asifahamed-ece/UsbAudioDac/USB_Audio_DAC_1.0/Core/Src/main.c

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
/* Includes ------------------------------------------------------------------*/
#include "main.h"
#include "usb_device.h"

/* USER CODE BEGIN Includes */
#include "audio_i2s.h"
#include "audio_fft.h"
#include "visualizer.h"
/* USER CODE END Includes */

I2S_HandleTypeDef hi2s2;
DMA_HandleTypeDef hdma_spi2_tx;

/* USER CODE BEGIN PV */
/* The 1 kHz sine test buffer (AUDIO_BUFFER[882]) and the
 * Phase 2 sine-generation code are removed. The DMA now runs
 * on audio_i2s_buffer (in audio_i2s.c), which the I2S callbacks
 * refill from the USB ring buffer. */

/* Independent watchdog (~1 s window, refreshed every main-loop pass).
 * File-scope (not static) so the CubeMX-generated handle stays visible to
 * the IWDG HAL; instance is the shared IWDG peripheral. */
IWDG_HandleTypeDef hiwdg;
/* USER CODE END PV */

void SystemClock_Config(void);
static void MX_GPIO_Init(void);
static void MX_DMA_Init(void);
static void MX_I2S2_Init(void);
/**
  * @brief  The application entry point.
  * @retval int
  */
int main(void)
{

  /* MCU Configuration--------------------------------------------------------*/

  /* Reset of all peripherals, Initializes the Flash interface and the Systick. */
  HAL_Init();

  /* Configure the system clock */
  SystemClock_Config();

  /* USER CODE BEGIN SysInit */
  /* Spectrum visualizer: arm the FFT double-buffer BEFORE
   * AudioI2S_Init() starts circular DMA — otherwise the refill ISR
   * (DMA1_Stream4, priority 0) could call AudioFFT_PutSamples()
   * while Init clears flags / memset(tap_buf) / builds the Hann
   * window. AudioFFT_Init has no I2S/USB dependency (RFFT table,
   * window, flags only). */
  AudioFFT_Init();
  /* USER CODE END SysInit */

  /* Initialize all configured peripherals */
  MX_GPIO_Init();
  MX_DMA_Init();
  MX_I2S2_Init();

  /* Start the I2S consumer BEFORE USB enumeration so the
   * peripheral is already clocking out silence from a zeroed
   * buffer. When the USB host opens its audio pipe and the
   * ring starts filling, the I2S callbacks (in stm32f4xx_it.c)
   * will start pulling samples from the ring into the buffer.
   *
   * Order matters: if USB started first, the ring would fill
   * but nothing would drain it — by the time I2S started, the
   * ring could be overflowing on a bursty source. */
  AudioI2S_Init();

  MX_USB_DEVICE_Init();
  /* USER CODE BEGIN 2 */
  /* (Phase 2 1 kHz sine generation removed; the I2S DMA now
   * streams from audio_i2s_buffer, which is refilled from the
   * USB ring buffer.) */

  /* TFT visualizer: ST7735 SPI bring-up + splash. Must run BEFORE
   * the IWDG starts — the splash blocks in HAL_Delay for ~3.5 s,
   * which would trip a ~1 s watchdog mid-animation and reset the MCU. */
  Visualizer_Init();

  /* Start the independent watchdog: LSI (~32 kHz) / 64 = 500 Hz,
   * reload 500  ->  ~1.0 s timeout. Refresh happens in the main
   * loop; a hang ends in an IWDG reset instead of a dead device.
   *
   * NOTE: IWDG keeps counting while the CPU is halted, so with the
   * watchdog enabled a debugger cannot halt the core (it resets
   * ~1 s later). Build with -DDEBUG_NO_WATCHDOG to disable it for
   * SWD debugging. */
#if !defined(DEBUG_NO_WATCHDOG)
  hiwdg.Instance = IWDG;
  hiwdg.Init.Prescaler = IWDG_PRESCALER_64;
  hiwdg.Init.Reload = 500;
  if (HAL_IWDG_Init(&hiwdg) != HAL_OK)
  {
    Error_Handler();
  }
#endif
  /* USER CODE END 2 */

  /* Infinite loop */
  /* USER CODE BEGIN WHILE */
  while (1)
  {
#if !defined(DEBUG_NO_WATCHDOG)
    HAL_IWDG_Refresh(&hiwdg);
#endif
    /* USER CODE END WHILE */

    /* USER CODE BEGIN 3 */
    Visualizer_Update();
  }
  /* USER CODE END 3 */
}

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
/* USER CODE BEGIN 4 */

/* HAL I2S callbacks (HAL_I2S_TxHalfCpltCallback / HAL_I2S_TxCpltCallback)
 * are implemented in stm32f4xx_it.c — they route to AudioI2S_RefillHalfA/B
 * which pull samples from the ring buffer. See stm32f4xx_it.c. */

/* USER CODE END 4 */
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
