asifahamed-ece/UsbAudioDac/USB_Audio_DAC_1.0/USB_Audio_DAC_1.0.ioc

Mcu.UserName=STM32F411CEUx
PA11.Signal=USB_OTG_FS_DM
PA12.Signal=USB_OTG_FS_DP
PA9.Signal=USB_OTG_FS_VBUS
PB10.Signal=I2S2_CK
PB12.Signal=I2S2_WS
PB15.Signal=I2S2_SD
