asifahamed-ece/UsbAudioDac/(commit log)

2026-09-04 Add BOM
2026-09-04 Update : Sine wave Intro and Bug fixes
    [main.c]
2026-09-05 Config I2S Clock Bus fixed
    [USB_Audio_DAC_1.0.ioc]
2026-09-05 Update Fixed the 1 KHz Sine Generation
    [main.c]
2026-09-05 Add ST USB Device Library (Audio + Core)
    Vendor library from STMicroelectronics, unmodified. Provides the
    USB Audio Class 1.0 class driver (usbd_audio.c) and the OTG FS
    core (usbd_core.c, usbd_ctlreq.c, usbd_ioreq.c). Application
    side is wired up in USB_DEVICE/App/ in a follow-up commit.
2026-09-05 Wire up USB Audio device on Black Pill
    - USB_DEVICE/App/usbd_audio_if.c: bridges the class driver to
    our ring buffer; AUDIO_CMD_PLAY calls RingBuffer_Write with the
    host's isochronous OUT packet. HalfTransfer_CallBack_FS and
    TransferComplete_CallBack_FS are the user-side hooks that the
    I2S HAL callbacks must invoke (the ST library never calls them
    itself - this is the root cause of the silent-enumeration bug).
    - USB_DEVICE/App/usbd_desc.c: device descriptor + configuration
    descriptor; one mono streaming endpoint, bNrChannels=1.
    - USB_DEVICE/Target/usbd_conf.c: HAL_PCD_MspInit, vbus_sensing
    DISABLE (F411 PA9 isn't routed to VBUS on the WeAct Black Pill,
    so B-session detection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
2026-09-05 Add ring buffer, I2S consumer, and USB Sync wiring
    - ring_buffer.c: SPSC ring (1024 int16, power of 2) shared
    between the USB producer (in usbd_audio_if.c) and the I2S
    consumer. head==tail is empty; one slot is sacrificed to
    disambiguate full. No locks - safe because USB writes from a
    single ISR and I2S reads from a single ISR.
    - audio_i2s.c: pulls mono int16 from the ring and lays them
    into the I2S DMA buffer as L=R (stereo). Underrun policy is
    silence (memset zero), so a brief stall doesn't pop.
    - stm32f4xx_it.c: HAL_I2S_TxHalfCplt/TxCplt callbacks now call
    HalfTransfer_CallBack_FS/TransferComplete_CallBack_FS FIRST
    (which routes to USBD_AUDIO_Sync -> AUDIO_CMD_PLAY ->
    Ri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
    [audio_i2s.c, audio_i2s.h, main.c, ring_buffer.c, ring_buffer.h]
2026-09-05 Update Makefile and CubeMX project for USB + I2S
    - Makefile: add C sources for new ring_buffer, audio_i2s, and
    USB device app/conf files; include paths for the ST USB
    Middleware and USB_DEVICE directories.
    - .ioc: enable USB OTG FS Device_Only, add DMA1 Stream4
    request for I2S2_TX, set USBD_AUDIO_FREQ=44100, add I2S2
    master-receive configuration. Generated by CubeMX; do not
    hand-edit between regenerations.
2026-09-05 Sync PROGRESS and PLAN with the working Phase 3 state
    Three categories of correction:
    - Clock config: both docs described a 60 MHz SYSCLK design that
    was never actually put in the .ioc. The board runs 48 MHz
    (PLLM=25, PLLN=384, PLLP=DIV8). Updated Phase 1 config,
    clock-tree math, and the H2 heading.
    - Phase 3 marked complete. Final config is 44.1 kHz / 16-bit /
    mono, 88-byte packets every 1 ms, ring buffer 1024 int16
    (~23 ms). Replaced the 48 kHz / 480-sample planning numbers
    with the actual numbers from the .ioc and usbd_conf.h.
    - Three-bug story added to PROGRESS.md: VBUS sensing blocking
    D+ pull-up (Bug 1, usbd_conf.c:342), hardcoded
    USBD_AUDIO_FREQ=48000U in usbd_conf.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
2026-09-10 docs: add README.md with project overview, build instructions, and wiring diagrams
2026-09-10 docs: fix CLAUDE.md — correct PLLI2SR=2, I2S=96MHz, source structure, pins
2026-09-10 docs: fix CLAUDE.md — correct sample rate to 44.1kHz, I2S pins PB10, status to Phase 3
2026-09-10 docs: fix PROGRESS.md — correct PLLI2SR=2, I2S=96MHz, PLLI2S config location
2026-09-10 docs: fix IMPLEMENTATION_PLAN.md — correct PLLI2SR=2, I2S=96MHz, SPI1/ST7735S, bmAttributes=0x00
2026-09-17 ld: add CCMRAM region/section, bump stack to 0x1000
    Resolve two deferred items: expose the 64K CCMRAM at 0x10000000 via a
    .ccmram section (NOLOAD, CPU-only - DMA buffers must stay in RAM), and
    raise _Min_Stack_Size to 0x1000 to make room for printf/FreeRTOS later.
2026-09-17 tests: add host unit tests for SPSC ring buffer
    Host-simulated suite for the USB->I2S lock-free ring: empty/full
    invariants, power-of-2 wraparound, partial ops, reset, 5000-iteration
    producer/consumer churn, and a global-stream integrity check across
    many wraps. ring_buffer.c compiles unmodified with host gcc (no HAL).
    Run with: make -C tests run. Clean under ASan/UBSan; 5227 checks pass.
2026-09-17 wdog: supervise main loop with independent watchdog (~1s)
    Enable HAL_IWDG_MODULE_ENABLED, link the IWDG driver, and start the
    windowless watchdog in main() USER CODE 2 (LSI/64 = 500 Hz, reload 500
    -> ~1.0 s). Refreshed each main-loop pass in USER CODE 3. A stuck main
    loop or hard fault now ends in a clean reset instead of a dead device.
    All IWDG wiring stays inside USER CODE blocks so CubeMX regeneration
    won't clobber it.
    [main.c]
2026-09-17 build: add flash/test/size convenience targets
    make flash - st-flash write the built .bin at 0x08000000
    make test - run host-simulated ring-buffer unit tests
    make size - print per-section memory usage of the .elf
    flash and size depend on the built artifacts; test needs no ARM toolchain.
2026-09-19 Rm BOM
2026-09-19 Added Wiring Pin Config
2026-09-19 Updated : Added Wiring Configs
2026-09-19 Updated MAX Wiring
2026-09-20 Update Fix Samples Overflow
    [main.c]
2026-09-20 Fix USBD_AUDIO_Sync stale data: compute available bytes and pass rd_ptr offset
    AudioCmd typedef now accepts a uint32_t offset parameter so the
    callback knows where in the circular buffer fresh data starts.
    USBD_AUDIO_Sync previously always copied AUDIO_TOTAL_BUF_SIZE/2
    (3520 bytes) from buffer[0] regardless of how much new USB data had
    arrived. Only ~440 bytes were fresh; the rest were stale zeros,
    filling the ring buffer with silence interspersed with real audio.
    Now computes actual available bytes (forward distance from rd_ptr to
    wr_ptr), clamps to half-buffer max, saves old_rd_ptr before advance,
    and passes it as the offset to AudioCmd. The ±4 byte proportional
    adjustment (insufficient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
2026-09-20 Adapt AudioCmd callback to use circular buffer offset
    AUDIO_AudioCmd_FS now receives the byte offset into the USB
    intermediate buffer where fresh data starts (old_rd_ptr from
    USBD_AUDIO_Sync). Reads from (pbuf + offset) instead of pbuf,
    ensuring the ring buffer receives actual audio samples instead of
    stale zeros from the start of the circular buffer.
    Template file updated to match the new AudioCmd signature.
2026-09-20 Fix circular buffer wrap-around in USBD_AUDIO_Sync
    When old_rd_ptr + BufferSize crosses the end of haudio->buffer[],
    the contiguous read from buffer[old_rd_ptr] would read past the
    array boundary into the struct's offset/rd_ptr/wr_ptr fields.
    Those stale struct values were interpreted as audio samples,
    causing the harmonic echo artifacts and clicks.
    Split the AudioCmd transfer into two calls when wrapping:
    1. first_chunk: from old_rd_ptr to end of buffer
    2. second_chunk: from start of buffer for the remainder
    Each chunk is independently capped by the ring buffer's own
    overflow protection in RingBuffer_Write.
2026-09-21 audio_i2s.c: add consumer-boundary diagnostics for ~100 Hz artifact
    Non-behavioral counters at the I2S half refill (5 ms cadence) to localize
    the 100 Hz gap seen on a steady 1 kHz tone:
    dbg_refill_calls - total HalfA+HalfB refills (events/sec = count/seconds)
    dbg_partial_count - refills that got < 220 mono (consumer starvation)
    dbg_partial_short - total missing mono samples
    dbg_late_gap - refill gaps > 6 ms (missed half window / latency)
    dbg_max_gap_ms - largest inter-refill gap
    dbg_min_read - smallest mono read this run
    Read via SWD/GDB while the tone chatters. Non-zero partial_count at
    ~200/s => starvation; non-zero late_gap => callback latency. Bui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
    [audio_i2s.c]
2026-09-21 usbd_audio: make USB->I2S bridge lossless (ring backpressure + sizing)
    The producer (USBD_AUDIO_Sync -> AUDIO_CMD_PLAY) could push up to
    AUDIO_TOTAL_BUF_SIZE/2 = 1760 mono samples per sync, but the consumer
    ring only held 1023 and AUDIO_AudioCmd_FS silently dropped overflow
    while Sync advanced rd_ptr past the unwritten bytes. That silent loss
    produced cadence glitches (the ~100 Hz / multi-frequency buzz on a
    steady 1 kHz tone).
    Fix (two parts, kept consistent):
    - RING_BUFFER_SIZE 1024 -> 2048 (>= worst-case single sync push)
    - USBD_AUDIO_Sync caps its per-sync copy to the ring's free space, so
    rd_ptr never advances past data the PLAY callback cannot store:
    lossless backpressure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
    [ring_buffer.h]
2026-09-21 audio_i2s: fix I2S buffer size 882->880 for stereo frame alignment
    The DMA half of an 882-halfword buffer is 441 words = an ODD count, so
    the 5 ms half-boundary split a stereo frame (L/R in different halves),
    leaving a stale word at every boundary. This injected a ~200 Hz / 100 Hz
    amplitude-phase glitch confirmed by recording analysis (200.01 Hz envelope
    peak, 100.2 Hz autocorr) and by the frequency meter oscillating to 100 Hz.
    880 -> half = 440 words = 220 whole stereo frames, exactly matching the
    220-mono refill (440 words). RefillHalfA writes 0..439, RefillHalfB
    440..879; fully aligned, no stale word.
    Also: silence -Wmemset-elt-size (byte count == element count now) and
    update stale 8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
    [audio_i2s.c, audio_i2s.h]
2026-09-21 usbd_audio: accept the 90-byte USB long frame (was dropping 1 sample/10 ms)
    For mono 44.1 kHz the host sends 9 packets of 88 bytes + 1 packet of 90
    bytes every 10 ms (44.1 samples/ms). The EP was opened and every
    PrepareReceive sized to AUDIO_OUT_PACKET=88 while the descriptor
    advertised 176 (the stereo macro). The 90-byte long frame was clipped,
    silently dropping 1 mono sample every 10 ms -> the exact 100 Hz glitch
    seen as a 1 kHz<->100 Hz meter hop on a steady tone.
    Fixes (AUDIO_FIX_PLAN Bug 2):
    - header: add AUDIO_OUT_PACKET_MAX 90U (buffer size stays 88*80=7040)
    - descriptor wMaxPacketSize -> LOBYTE/HIBYTE(AUDIO_OUT_PACKET_MAX)=90
    - OpenEP + all three PrepareReceive -> AUDIO_OUT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
2026-09-21 audio_i2s: acoustic-isolation diagnostic - generated 1 kHz (bypass USB)
    Temporary diagnostic to bisect the remaining 200/300 Hz buzz between the
    USB/ring data path and the amplifier/power/speaker.
    When dbg_bypass_usb (default 1) the I2S DMA buffer is filled with a
    phase-continuous generated 1 kHz sine, bypassing USB+ring entirely, while
    leaving DMA1_Stream4 -> I2S2 -> MAX98357A -> speaker unchanged.
    - clean tone => USB/ring path is the culprit (fix feedback / margin)
    - still buzzy => amp/power/speaker is the culprit (hardware)
    Set dbg_bypass_usb=0 over SWD/GDB to restore normal USB playback without
    reflashing. REMOVE after the test.
    [audio_i2s.c]
2026-09-21 usbd_conf: enable SOF interrupt for async feedback endpoint
    FATAL bug fix (AUDIO_FIX_PLAN Bug 1): Sof_enable was DISABLE, which
    masks GINTMSK_SOFM in the USB OTG peripheral (stm32f4xx_ll_usb.c:452).
    Without SOF interrupts USBD_AUDIO_SOF never fires, so the feedback
    endpoint never transmits rate correction to the host.
    Result: host sends at nominal 44100 Hz while I2S consumes at 44117.6 Hz
    (PLLI2S real rate) -> 17.6 samples/s drain -> ring empties in ~113s.
    Fix: Sof_enable = ENABLE. This is the standard ST CubeMX trap for anyone
    adding async feedback to USB Audio Class 1.0 — the .ioc generator defaults
    to DISABLE and never warns you.
2026-09-21 Fix interrupt priority inversion: DMA I2S now preempts USB
    CRITICAL: The 400Hz/300Hz modulation artifacts in recordings 2&3 were
    caused by USB (priority 0) preempting audio DMA callbacks (priority 5).
    SOF interrupts fire at 1000 Hz. When a DMA half-complete ISR starts
    executing RefillHalfA/B at t=5ms, USB can preempt it mid-operation. By
    the time control returns to the DMA ISR, the DMA has already started
    reading the not-yet-refilled buffer -> plays stale/zero data -> 200Hz
    gap pattern -> 400Hz second harmonic.
    New priorities:
    DMA1_Stream4_IRQn = (0, 0) <- HIGHEST (was 5)
    OTG_FS_IRQn = (3, 0) <- LOWER (was 0)
    Audio DMA callbacks are time-critical (must complete within ~5ms)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
    [main.c]
2026-09-23 feat(display): add ST7735S SPI1 driver with 6x8 font and rect primitives
2026-09-23 fix(display): correct RGB565 wire byte order; add display settle delays; stream text per-char window
    [st7735.c]
2026-09-23 feat(ui): wire Visualizer_Init/Update into main loop
2026-09-23 fix(dsp): calibrate dB mapping for full-scale input; drop dead FS macro
    [audio_fft.c, audio_fft.h]
2026-09-23 fix: arm AudioFFT before live I2S ISR; correct spec band index; render clamp
    [audio_fft.c, main.c, visualizer.c]
2026-09-23 fix: move Visualizer_Init after USB enumeration to avoid host timeout
    USB hosts expect enumeration within ~100ms. The previous order had
    AudioFFT_Init + Visualizer_Init (~1.5s of delays: 450ms ST7735 init
    + 1s splash) running BEFORE MX_USB_DEVICE_Init, causing the host to
    give up before the device finished initializing.
    Order is now: USB init first (fast enumeration), then display init
    (still before IWDG to avoid watchdog trip during splash).
    [main.c]
2026-09-23 fix: remove invalid CCMRAM usage causing HardFault on STM32F411
    STM32F411 has no CCMRAM at 0x10000000 (F405/F407 feature only).
    FFT buffers now use normal SRAM .bss. Also set dbg_bypass_usb=0
    to restore USB audio playback (was testing with 1kHz sine).
    - audio_fft.c: removed CCM attribute from 7 buffers + rfft_instance
    - audio_i2s.c: dbg_bypass_usb 1U -> 0U
    Root cause: memset(tap_buf, ...) at 0x10000000 triggered BusFault
    before MX_USB_DEVICE_Init(), preventing enumeration entirely.
    [audio_fft.c, audio_i2s.c]
2026-09-23 fix: USB audio circular-buffer overrun causing screech + device disappear
    Root cause (commit 13f0f09 regression): AUDIO_OUT_PACKET_MAX was raised
    to 90 bytes but buffer stayed at 88*80=7040. Every ~80 ms a 90-byte
    long frame was armed at buffer[wr_ptr] near the end; the HAL copied
    the full frame linearly, writing 16+ bytes past the array end into the
    struct's own rd_ptr/wr_ptr/control fields. Corrupted rd_ptr -> OOB
    ring reads -> screeching from t~80ms. Corrupted wr_ptr -> wild
    PrepareReceive -> BusFault -> HardFault_Handler while(1) -> device
    vanishes from USB bus. Volume drag was the trigger, not the cause.
    Fix 1 (root cause) - usbd_audio.h:
    buffer[AUDIO_TOTAL_BUF_SIZE] -> buffer[AUDIO_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
2026-09-23 Revert "fix: move Visualizer_Init after USB enumeration to avoid host timeout"
    This reverts commit b59082115dc93bc07752c58375013f9624c8283a.
    [main.c]
2026-09-23 Update TFT pinout section in README
    Removed warning about connecting the display to 5V.
2026-09-24 feat(ui): add synthwave visualizer prototype with smooth gradients, peak dots, particles and loading animations
2026-09-24 fix(ui): cyberpunk neon palette, smoothed bars, correct panel polarity and legible splash text
    - visualizer: swap blue/green/yellow GitHub theme for the design-spec
    magenta/cyan/indigo Cyberpunk Neon RGB565 palette; hot-pink peak dots
    - visualizer: smooth bar ballistics (per-band lerp, fast rise / relaxed
    fall) so heights glide instead of snapping at the FFT frame rate
    - visualizer: restore both old peak rows with the correct per-row zone
    color to eliminate dim ghost bands; rate-limit unchanged at 20ms
    - visualizer: 2x "USB AUDIO" splash title, SYNTHWAVE subtitle, indigo-
    cyan-magenta progress bar and READY marker; brighten separator and
    label text
    - st7735: add ST7735_USE_INVERSIO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
    [st7735.c, st7735.h, visualizer.c]
2026-09-24 fix(display): enable ST7735_USE_BGR for 1.44" ST7735S panel
    [st7735.c]
2026-09-24 fix(display): row-major 8x8 font rendering, fixes garbled glyphs
    Swap emission order to row outer / column inner: ST7735 fills a RAM
    window with X incrementing fastest, so the previous column-outer order
    transposed each glyph. Font switched to the classic row-major 8x8 table
    (bit 7 = leftmost pixel), matching the RescuePulse ST7735S build, with
    1x = 8x8 and 2x = 16x16, plus a centered-string helper.
    [st7735.c, st7735.h]
2026-09-24 feat(ui): RescuePulse-style dark skin with black spectrum background
    Full-width dark-slate header band with centered device title, dark
    panel frame around the spectrum with an explicitly black interior,
    centered splash stack (2x AUDIO / SYNTHWAVE / 44.1 kHz / READY) and
    a green READY status. Bar max height is pinned to the FFT's cap so
    differential bars can never paint over the panel border.
2026-09-24 feat(ui): 10-band rainbow LED-block spectrum, ~2s boot
    - Spectrum now renders as stacked LED blocks (6 px block + 1 px gap,
    heights snapped to whole blocks) instead of solid bars.
    - Each of the 10 columns gets its own rainbow color (red -> pink) via
    a 16->10 max-merge of the FFT bands, keeping full 172 Hz - 14 kHz
    coverage. Horizontal height-zone stripes are gone.
    - Bars widened (BAR_W 11, MARGIN_X 4) so 10 bars still span the panel.
    - Boot splash slowed to ~1.9 s (38 ms/fill step)
    [visualizer.c]
2026-09-24 fix(analyzers): volume-responsive dBFS bands and clean pause background
    - FFT now maps bands to absolute dBFS (full-scale sine = 0 dB = full
    bar) instead of renormalizing each frame against the loudest bin,
    which pinned bars near-full at any non-zero volume. Lowering the
    laptop volume lowers the bars; mute/zero still collapses them.
    - When the USB stream stalls (host paused and stopped sending audio),
    AudioFFT_Process now decays all bands toward zero so the display
    falls to a clean black background instead of freezing.
    - Visualizer peak-dot erase now always overwrites the old row (bar
    color for lit block rows, black otherwise) instead of early-returning
    above the bar, which str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
    [audio_fft.c, audio_fft.h, visualizer.c]
2026-09-24 feat(ui): perceptual 12-band visualizer with real sub-172 Hz bass
    - FFT N 256 -> 1024 (df 172 Hz -> 43 Hz): a true 60-250 Hz bass
    region is now resolvable; buffers stay in .bss (+~11 KB SRAM).
    - Band map: 16 log bands -> 12 perceptual bands (~43 Hz -> 12 kHz)
    split 2 bass (43-301 Hz) / 6 mids (301 Hz-4 kHz) / 4 highs
    (4-12 kHz). Top 17 kHz dead band removed.
    - Highs 4-12 kHz get a +6 dB presence lift (band_presence[], after
    the dB calc) so naturally-quiet HF gets its bars to dance instead
    of the old all-energy-on-the-left look.
    - Display: 10 -> 12 columns at 9 px width, 1:1 FFT->bar passthrough
    (identity merge), 12-color rainbow, labels 40 / 1k / 12k.
    - Tests: 1 kHz tone now maps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
2026-09-24 refactor(ui): region text labels (Lows/Mids/Highs) replace freq readouts
    Positioned under their color regions: Lows under bass bars 0-1
    (x=4), Mids centered under bars 2-7 (x=37), Highs under bars 8-11
    (x=83, right edge 122 == last bar).
    [visualizer.c]
2026-09-26 fix(audio): switch to exactly 48 kHz, removing the periodic zero-gap tap
    The I2S2 peripheral was running at 44 117.647 Hz (PLLI2S 96 MHz -> I2SDIV=34,
    ODD=0) while USB declared 44 100 Hz. That +400 ppm error meant the I2S
    consumed 17.6 samples/s more than the host delivered, so the 2048-sample
    ring slowly drained and every DMA refill came up short. Because
    AudioI2S_RefillHalfA/B zero the unfilled tail, each short refill became a
    zero-gap at the buffer rate -- a 100.27 Hz / 200.53 Hz "thud", several per
    second. There was no way for the host to correct it: the streaming interface
    declares only the OUT endpoint and USBD_AUDIO_SOF is a no-op stub, so the
    earlier Sof_enable fix was inert.
    An exh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
    [USB_Audio_DAC_1.0.ioc, audio_fft.c, audio_i2s.c, main.c, ring_buffer.h]
2026-09-26 fix(display): show the real sample rate, stop clipping the region labels
    Two display bugs, both consequences of the 48 kHz move and the panel's
    row offset going unnoticed.
    1. The header and splash still read "44.1k" / "44.1 kHz / I2S" after the
    rate changed. Rather than hardcode 48 again -- which is how it went
    stale once already -- the labels are now derived from the one constant
    that defines the rate:
    UI_RATE_NUM / UI_RATE_SHORT / UI_RATE_LONG <- USBD_AUDIO_FREQ
    The header rate is right-aligned to a 4 px margin so it mirrors the
    title's left margin now that it is 3 characters instead of 5.
    2. The Lows/Mids/Highs labels were drawn at y=120 and came out half
    cut.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
    [audio_fft.h, st7735.c, st7735.h, visualizer.c]
2026-09-26 feat(boot): retro sun + perspective grid splash
    Replaces the flat centred stack with a synthwave scene: banded sun disc,
    horizon, perspective grid with converging verticals, CRT scanlines, a
    colour-evolving progress bar, and a per-step status line.
    Design constraints that shaped it:
    - No framebuffer, no new driver primitives. SPI1 is 12 MHz, so a full
    128x128 repaint is 32768 B ~= 21.8 ms; a framebuffer animation would
    blow the boot budget in ten frames. The backdrop is painted once and
    each step repaints only the grid lines, the bar and a short 5x7 status
    string (~2.4 ms). A filled disc needs no driver support: each row's
    half-width is sqrt(r^2 - dy^2), so the sun is a run of Fi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
    [visualizer.c]
2026-09-26 fix(display): drop the 5x7 font, use font8x8 everywhere; SYNTHWAVE header
    Two problems reported from the flashed build.
    1. The 5x7 glyphs came out scrambled -- the same class of failure as the
    earlier "row-major 8x8 font rendering, fixes garbled glyphs" commit.
    Rather than debug a second font table, this deletes it. The project
    now has exactly ONE font (Core/Src/font8x8.h, the table that already
    renders correctly on this panel), rendered by the existing
    ST7735_DrawString / DrawStringCentered and pinned by the existing
    test_font_render.c. Removed:
    - Core/Inc/font5x7.h
    - ST7735_DrawString5x7 / ST7735_DrawStringCentered5x7
    - the ST7735_GLYPH5X7_* / ST7735_ADVAN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
    [st7735.c, st7735.h, visualizer.c]
2026-09-26 fix(boot): erase the status line, solid grid rays, drop the sky-wide scanlines
    Found by looking at photos of the flashed boot screen. Three real defects,
    two of them visible in the pictures.
    1. The status line was unreadable ("CIDNAЯS", "UITT TЯS"). Consecutive
    status strings have different lengths -- "CLOCKS" is 6 chars, "DMA" is
    3 -- and each was centred and drawn straight over the previous one, so
    the previous string's end pixels were never cleared. "USB FS" -> "RING"
    stranded 16 stale glyph pixels, "CLOCKS" -> "DMA" stranded 24. The band
    is now erased with a full-width FillRect before each redraw.
    2. The converging grid rays were dotted. They were walked with
    intege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
    [visualizer.c]
2026-09-26 fix(boot): held status words, cleaner sun, thinner grid
    The loading text still strobed past and left residue, and the sun was not
    reading cleanly. Rebuilt the animation around the 5 s budget the owner
    signed off on.
    Stale text edges -- root cause was two things, not one:
    1. The band was not erased before each redraw. Consecutive words have
    different lengths ("CLOCKS" is 6 chars, "DMA" is 3) and each was
    centred straight over the previous one, stranding up to 30 pixels of
    the old word. Verified by replaying the real draw sequence against a
    reference render of each word alone: 30 stray pixels without the
    erase, 0 with it. The previous commit added the erase; this one also
    o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
    [visualizer.c]
2026-09-26 feat(boot): continuous ground plane and a sun that sets behind the horizon
    The sun floating above the waves with the loading controls wedged between
    them was a deliberate trade, not an accident: the first layout put the bar
    and READY at rows 76-92, directly over the animated grid, covering 5 of its
    10 lines so the scroll looked broken. Moving the controls out of the grid
    fixed that but split the scene in two. This restores the shot.
    Layout, verified collision-free with 7 rows of bottom margin:
    rows 3- 18 AUDIO (2x) sky
    rows 21- 28 SYNTHWAVE sky
    rows 30- 37 USB AUDIO DAC sky
    rows 41- 68 sun disc, 28 px sky + submerged
    row 58 horizon lin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
    [visualizer.c]
2026-09-26 feat(display): left-align SYNTHWAVE, add a yellow rate stamp top right
    Spectrum-screen header: device name anchored left, rate stamp anchored
    right against the same 4 px margin, so the band reads as two ends rather
    than one centred blob.
    The stamp is built from USBD_AUDIO_FREQ at init, not written as a literal
    and not stringified with the preprocessor. That label has now failed both
    ways on this project: it read "44.1k" after the device moved to 48 kHz, and
    the fix that tried to derive it printed the literal text "48000U / 1000"
    because `#` does not macro-expand its argument. Converting the digits at
    runtime sidesteps both -- it cannot go stale, and it cannot print an
    expression. Verified: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
    [visualizer.c]
2026-09-26 docs: correct stale claims, prune clutter, add DEBUGGING.md
    Every figure below predated the move to exact 48 kHz or the switch to
    font8x8, and several were actively wrong rather than merely outdated.
    Code comments corrected against the code they describe:
    - visualizer.c: 10-band -> 12-band, boot splash ~1.9 s -> ~3.5 s
    (54 ticks x 55 ms + 500 ms hold), only "AUDIO" is 2x, mid band
    328-3328 Hz -> 328-4406 Hz, drop the removed "single grid row per
    step" description, "8 lines" -> GRID_ROWS, SUN_SLICE_H -> SUN_BAND_*.
    - audio_fft.c: band span ~43 Hz -> ~47 Hz, height map [0,90] -> [0,84].
    - main.c: hiwdg is not static; splash is ~3.5 s, not ~1 s.
    - audio_i2s.c: dbg_bypass_usb ships 0, not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
    [audio_fft.c, audio_i2s.c, audio_i2s.h, main.c, ring_buffer.c, ring_buffer.h, st7735.h]
2026-09-26 feat(display): merge Phase 5 TFT visualizer + boot splash; correct stale docs (#4)
    Squash-merge the Phase 5 display work plus the documentation audit into main.
    This also clears the standing hazard where main still carried the deleted 5x7 font.
    [USB_Audio_DAC_1.0.ioc, audio_fft.c, audio_fft.h, audio_i2s.c, audio_i2s.h, main.c, ring_buffer.c, ring_buffer.h]
2026-09-26 docs: drop the CH340 from the BOM, mark Phase 4/5 wiring honestly
    The BOM listed a USB-serial adapter as 'Optional, recommended for Phase
    4-6 debug output'. The firmware has no UART: USART2 is never
    initialised, the UART HAL driver is not in the Makefile, and
    USBD_DEBUG_LEVEL is 0, which compiles every USBD_ErrLog/USBD_DbgLog
    call to nothing. An adapter would have had nothing to connect to, so
    it is struck from the BOM and from WIRING.md's pin map.
    The EC11 encoder stays, but reframed: AUDIO_VolumeCtl_FS is a no-op
    and there is no software gain in the sample path, so the device has no
    volume control today. The encoder buys the *input* for Phase 4, not a
    working feature.
    Also corrects WIRIN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
2026-09-26 docs: BOM is now a plain parts list, no ownership flags
    Dropped the Status column and every owned/to-buy/optional marker. The
    README also had a second, near-duplicate component table under
    Hardware, so that is gone and its Role column folded into the BOM.
    Cost is now a real per-unit estimate (~$8-10) instead of $0, which
    only made sense while every line was marked owned. Aligns with the
    existing 'Low cost' feature claim.
    Kept one line on the absent USB-serial adapter: it explains why an
    expected item is missing, so nobody re-adds it.
2026-09-26 chore: point at the local datasheets, harden .gitignore
    The STM32F411CEU6/ folder holds the MCU datasheet, reference manual and
    a pinout image (git-ignored, ~12 MB). Consolidated docs had dropped the
    mention of it, so restore a pointer rather than leave the folder
    undocumented.
    .gitignore gains merge/editor leftovers (*.orig, *.rej, *.bak, *~),
    compile_commands.json, the audio test recordings that were captured
    while chasing the thuds (*.mp3, *.wav, *.m4a, *.aac), and Thumbs.db.
