asifahamed-ece/UsbAudioDac/(notices)

Notices in the files:
USB_Audio_DAC_1.0/Core/Src/main.c:
Copyright (c) 2026 STMicroelectronics.
All rights reserved.
This software is licensed under terms that can be found in the LICENSE file
README.md:
License: MIT
